gholdys/radyjko-357/pics/P1160269.webp

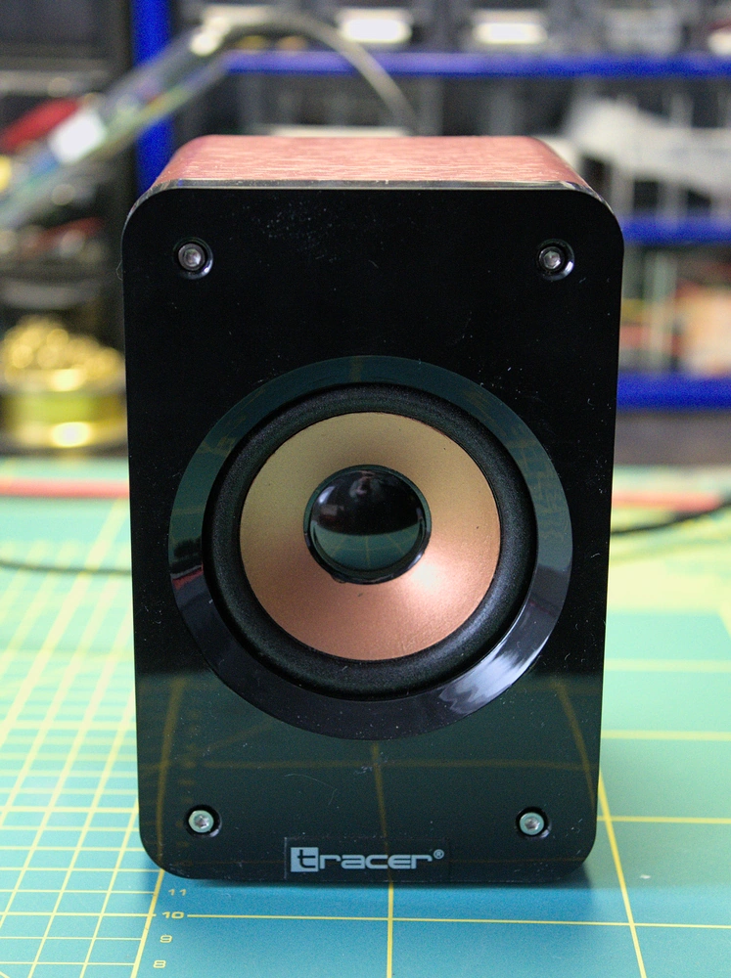
pics/P1160269.webp
