gholdys/radyjko-357/pics/P1160270.webp

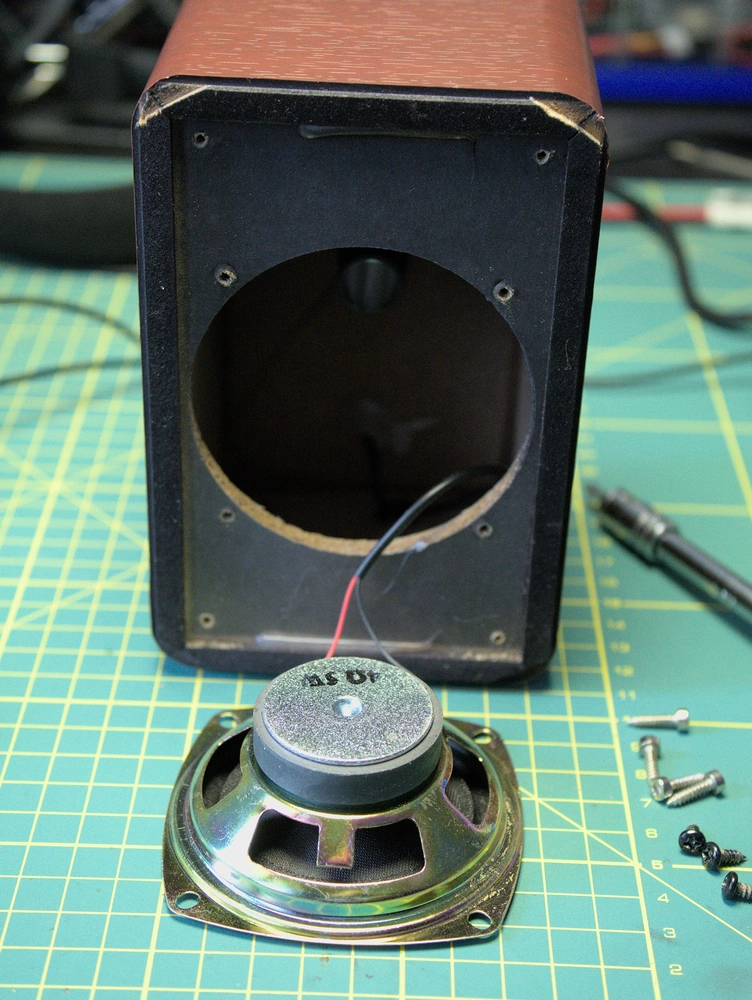
pics/P1160270.webp
