gholdys/radyjko-357/pics/P1160276.webp

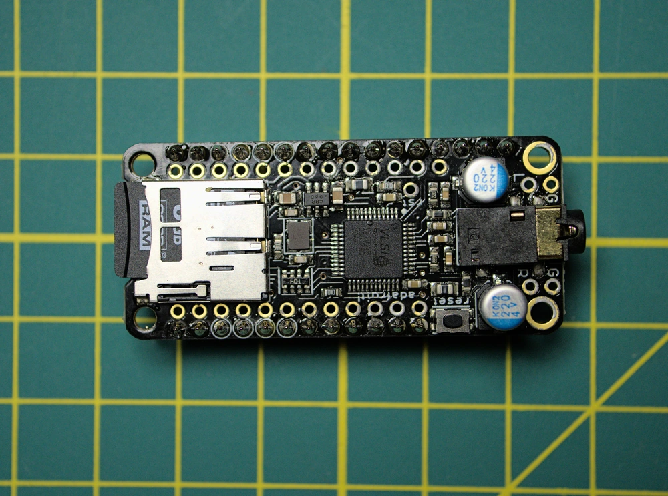
pics/P1160276.webp
