gholdys/radyjko-357/pics/P1160277.webp

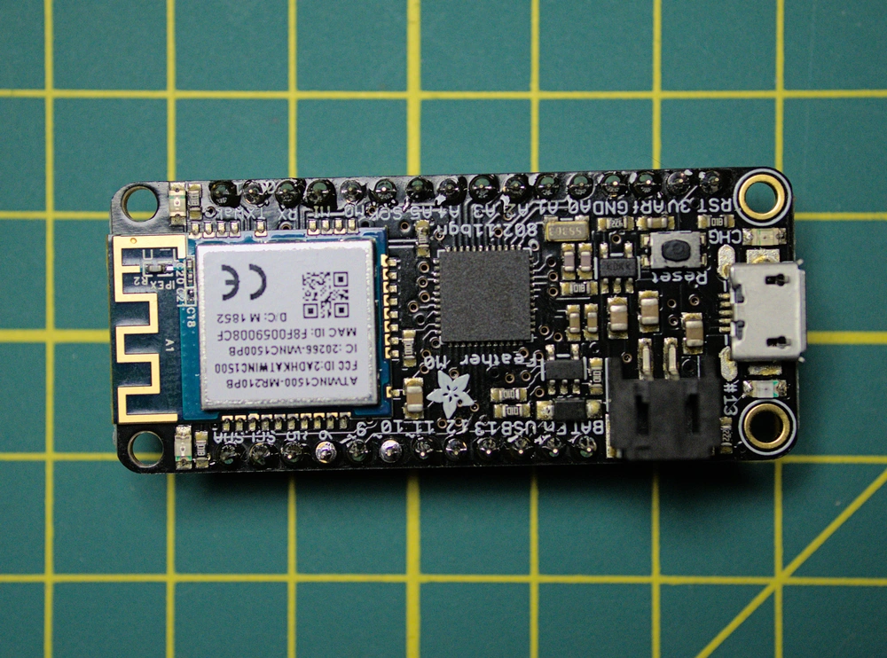
pics/P1160277.webp
