gholdys/radyjko-357/pics/P1160278.webp

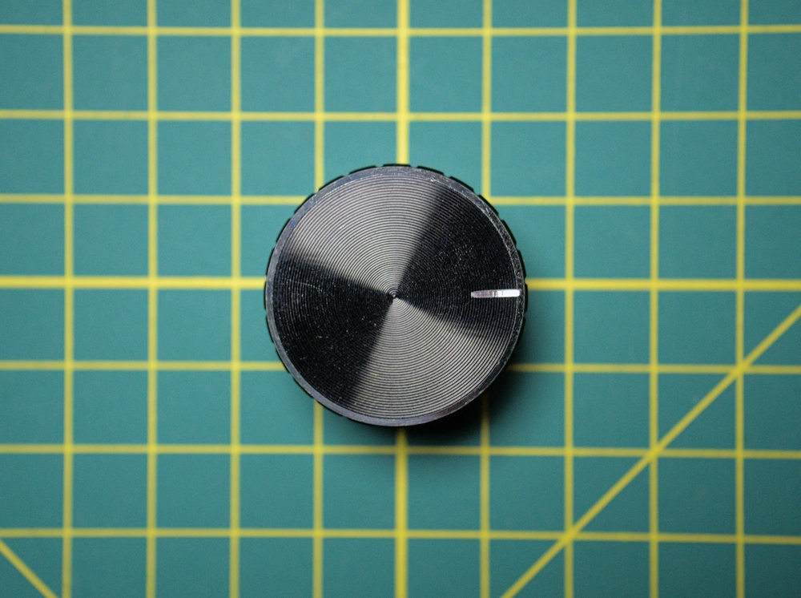
pics/P1160278.webp
