gholdys/radyjko-357/pics/P1160279.webp

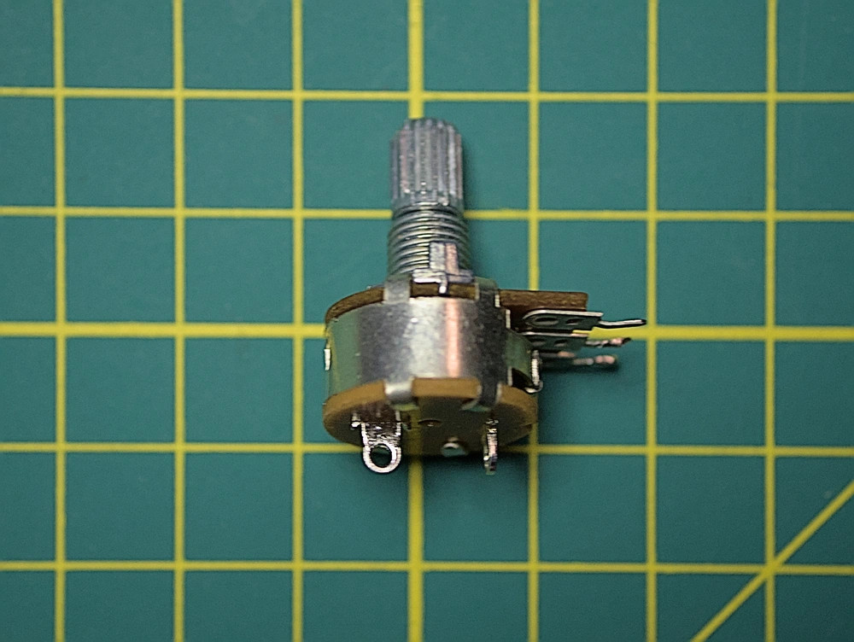
pics/P1160279.webp
