gholdys/radyjko-357/pics/P1160280.webp

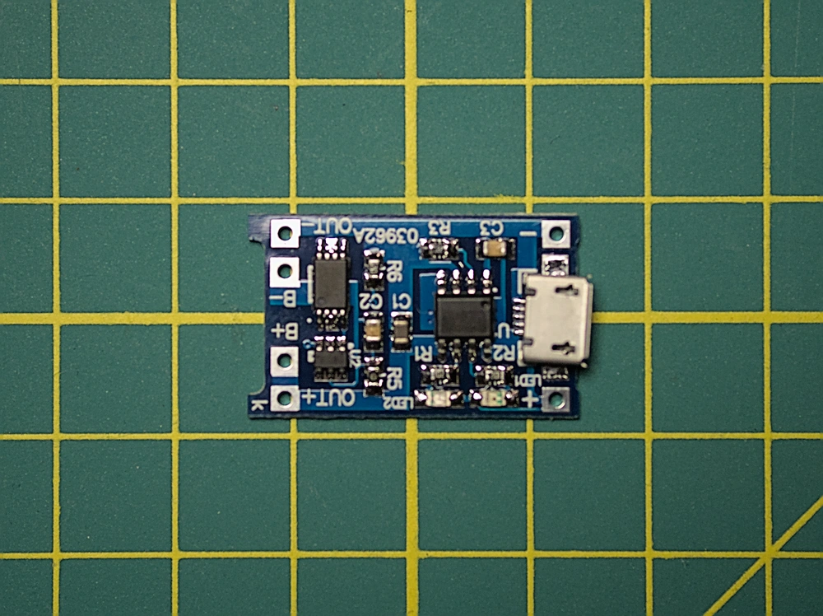
pics/P1160280.webp
