gholdys/radyjko-357/pics/P1160281.webp

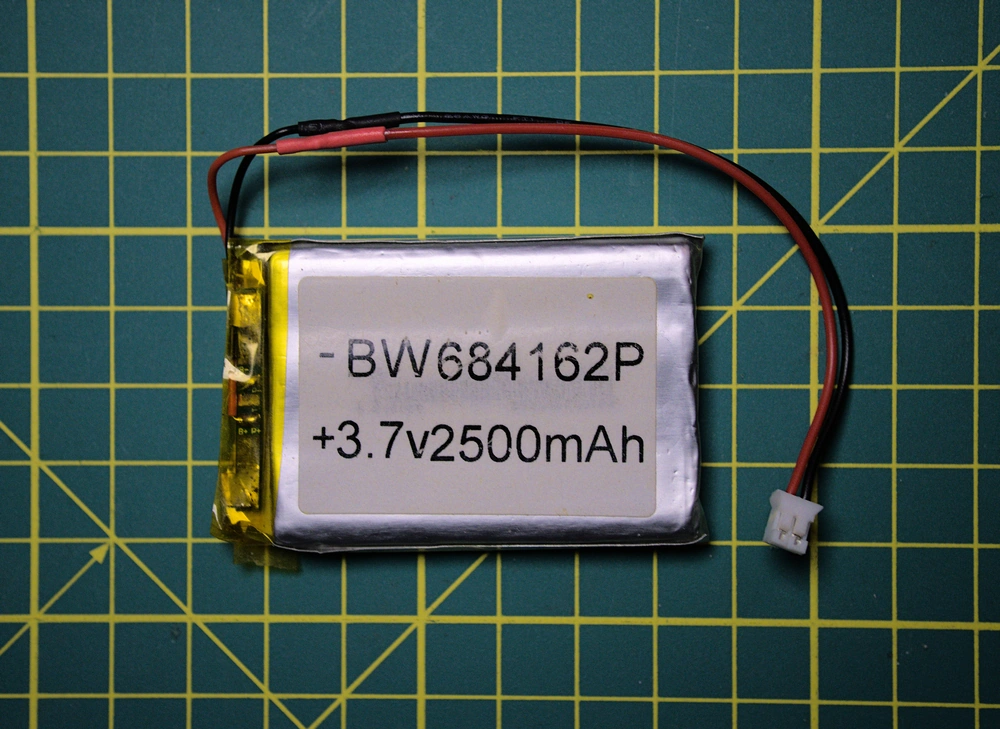
pics/P1160281.webp
