gholdys/radyjko-357/pics/P1160282.webp

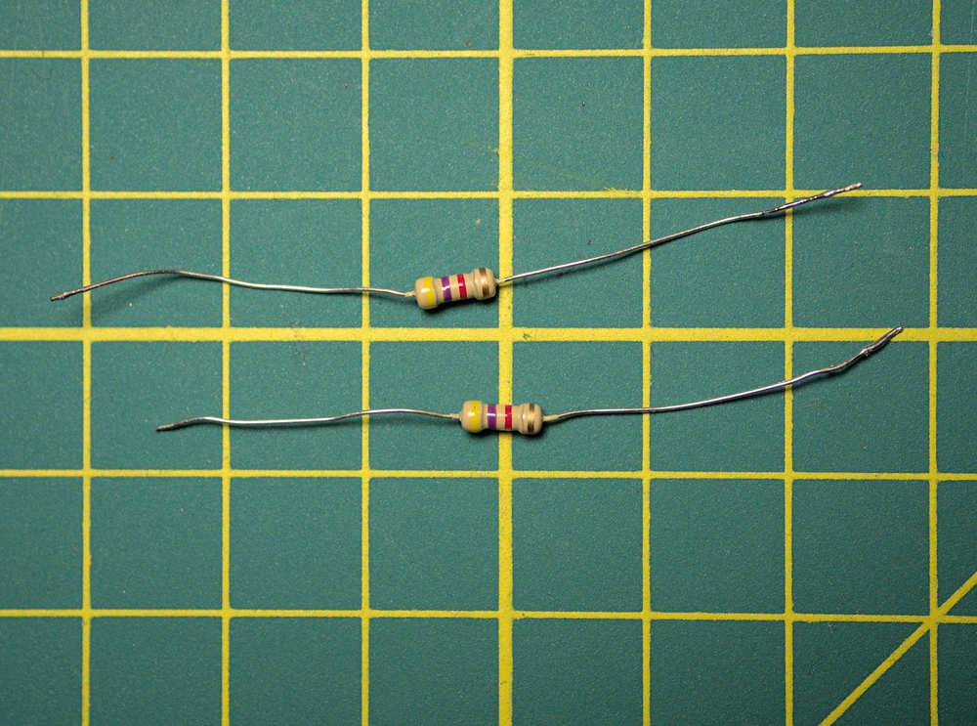
pics/P1160282.webp
