gholdys/radyjko-357/pics/P1160283.webp

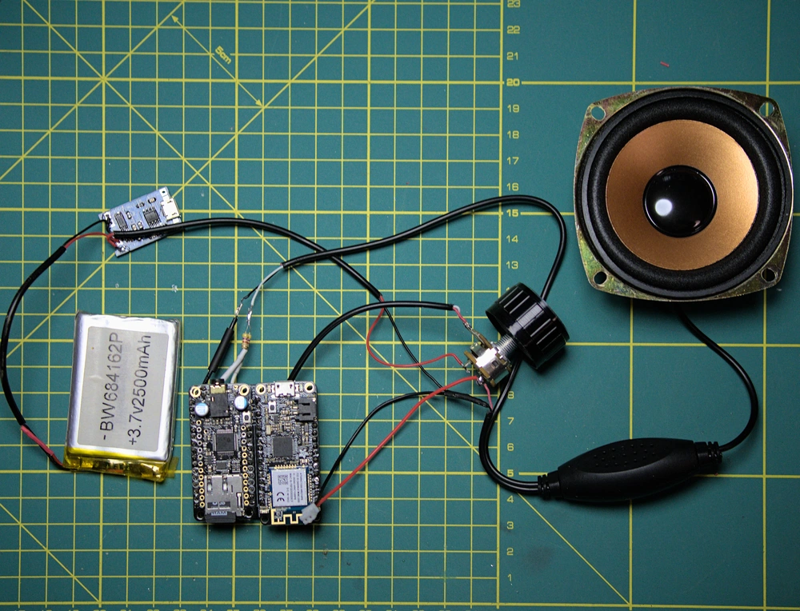
pics/P1160283.webp
