gholdys/radyjko-357/pics/P1160288.webp

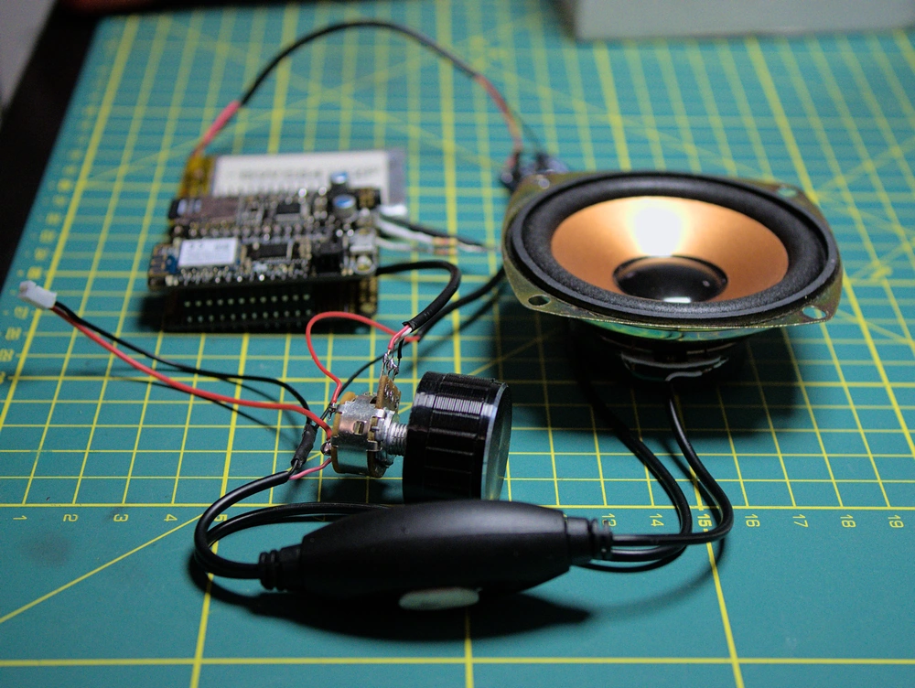
pics/P1160288.webp
