gholdys/radyjko-357/pics/P1160292.webp

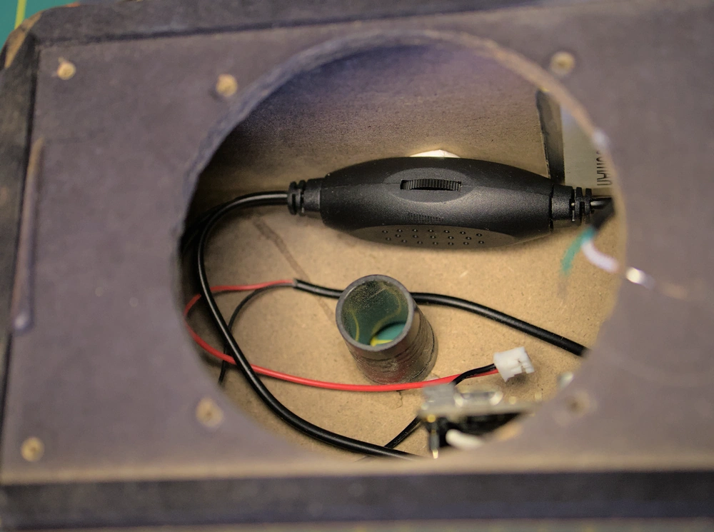
pics/P1160292.webp
