gholdys/radyjko-357/pics/P1160294.webp

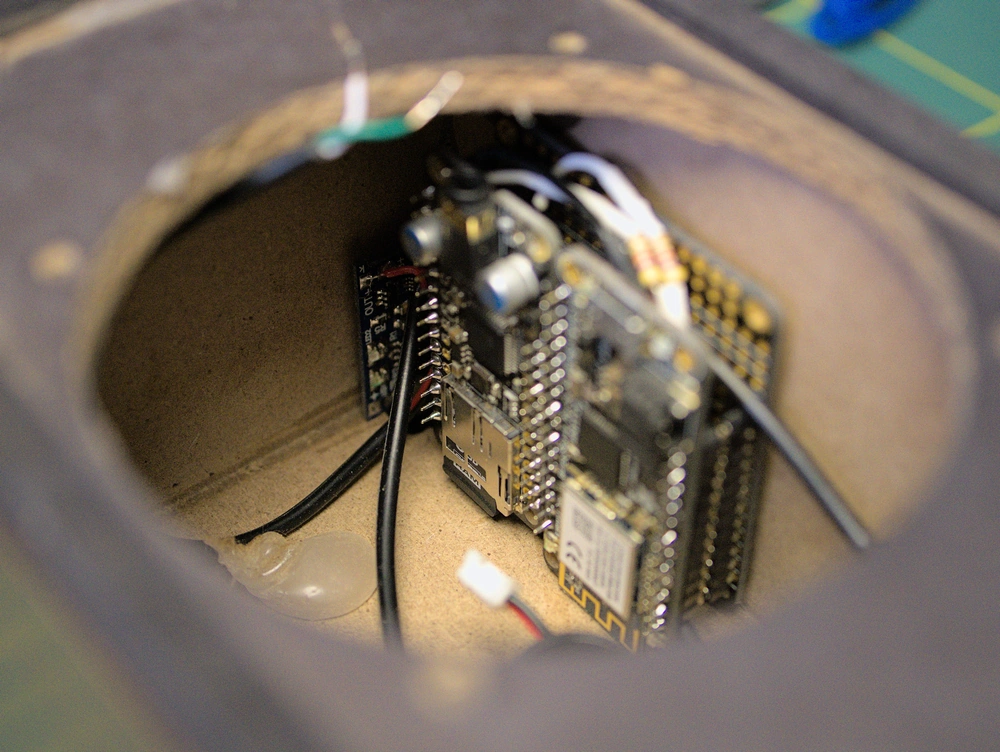
pics/P1160294.webp
